MASA-Dearborn/STACK_PMS/README.md

# PMS
Power Management System board
STACK_PMS
