MASA-Dearborn/STACK_PMS/Power Management System Schematic.pdf

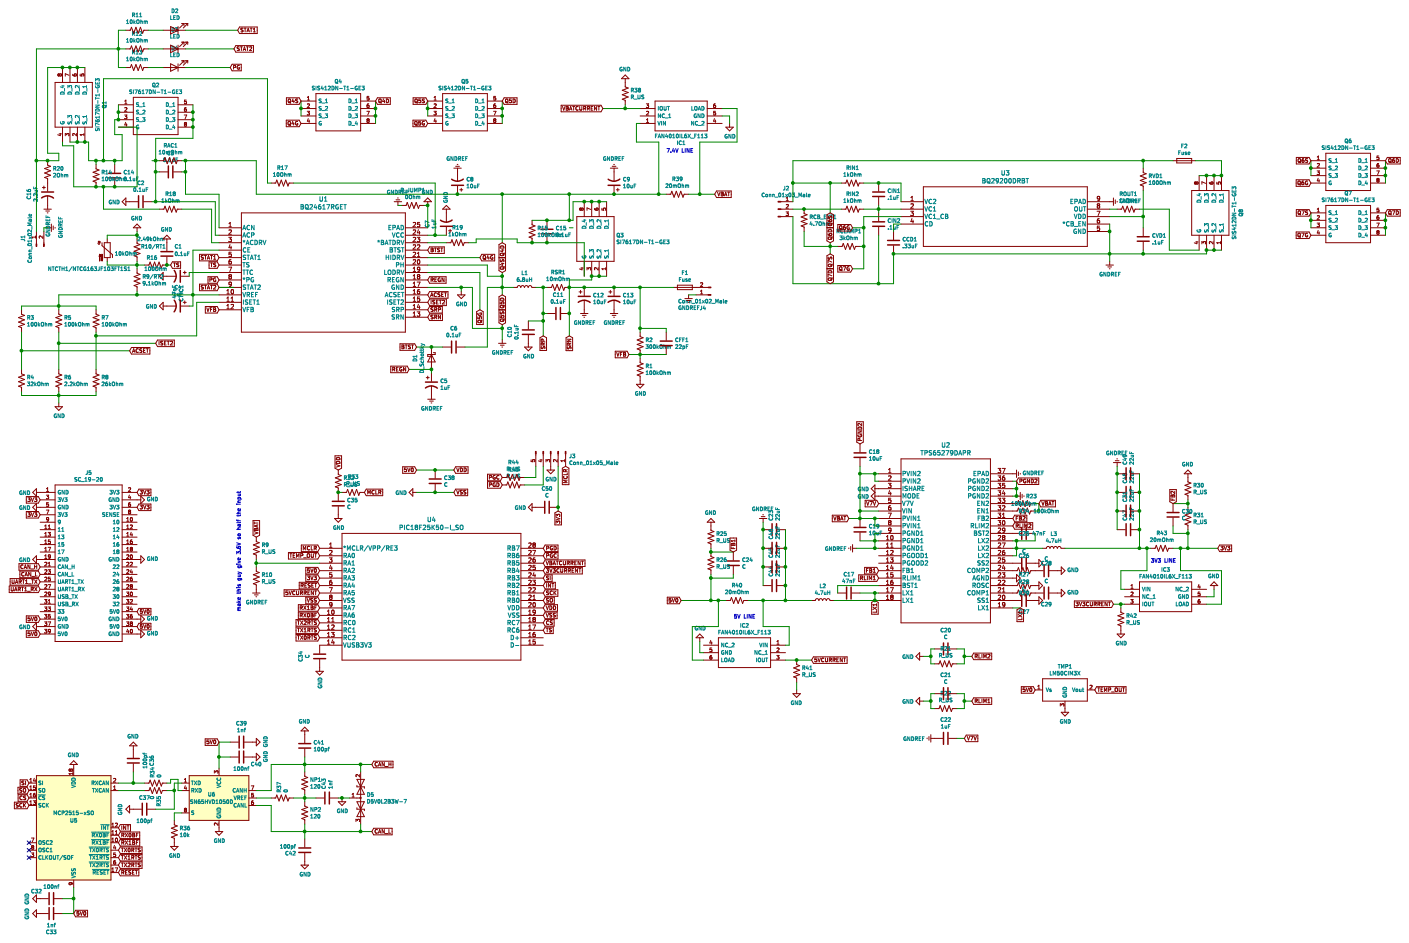
[picture p1: page 1]
