MASA-Dearborn/STACK_PMS/Power Management System GND Plane.pdf

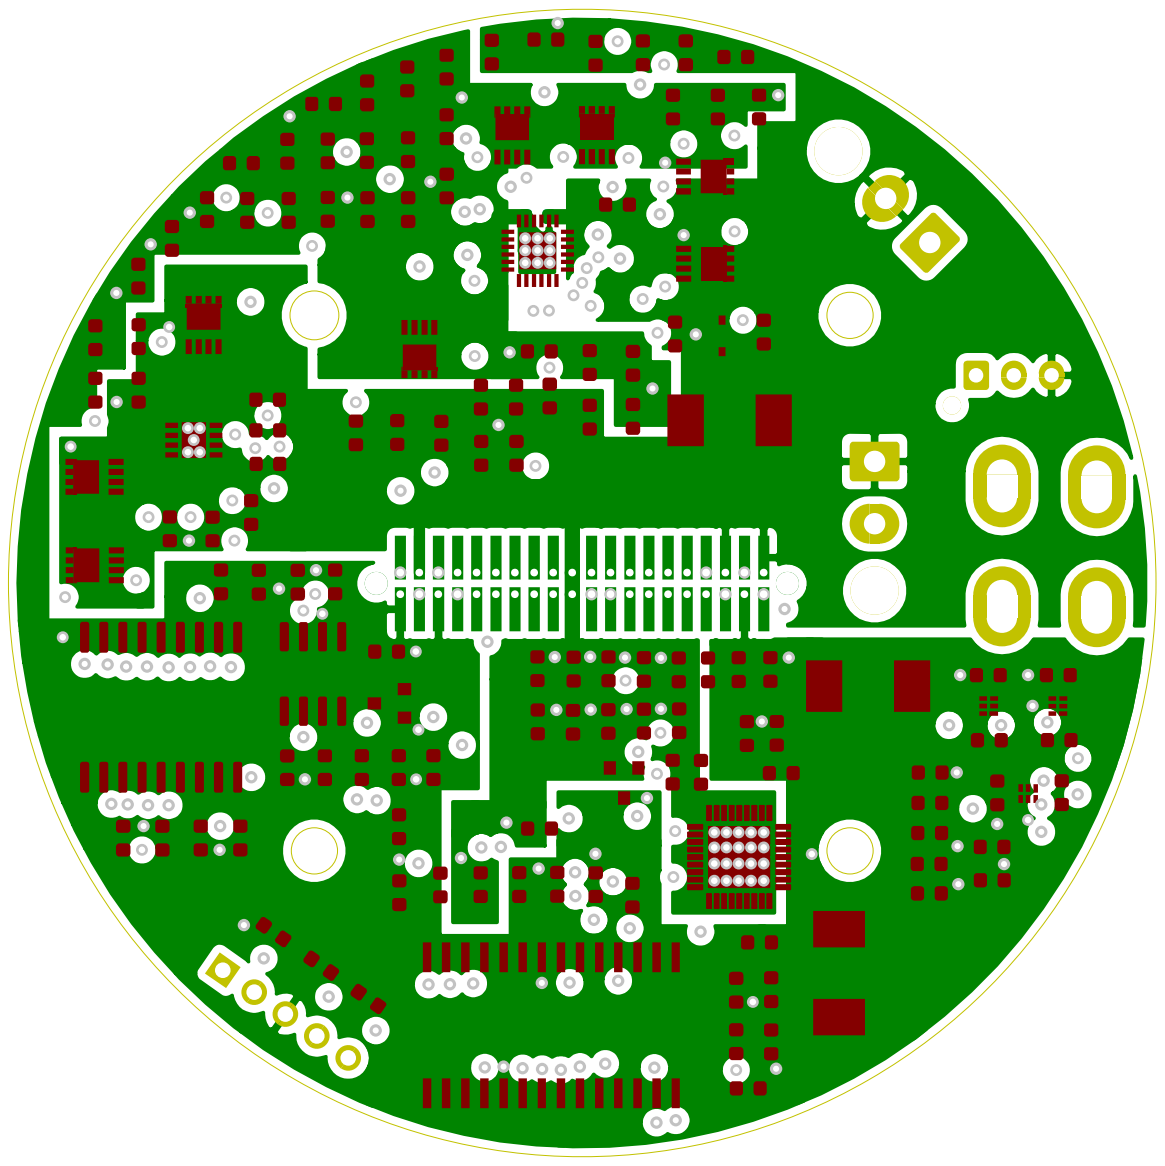
[picture p2: page 1]
