MASA-Dearborn/STACK_PMS/Power Management System Inner Layer.pdf

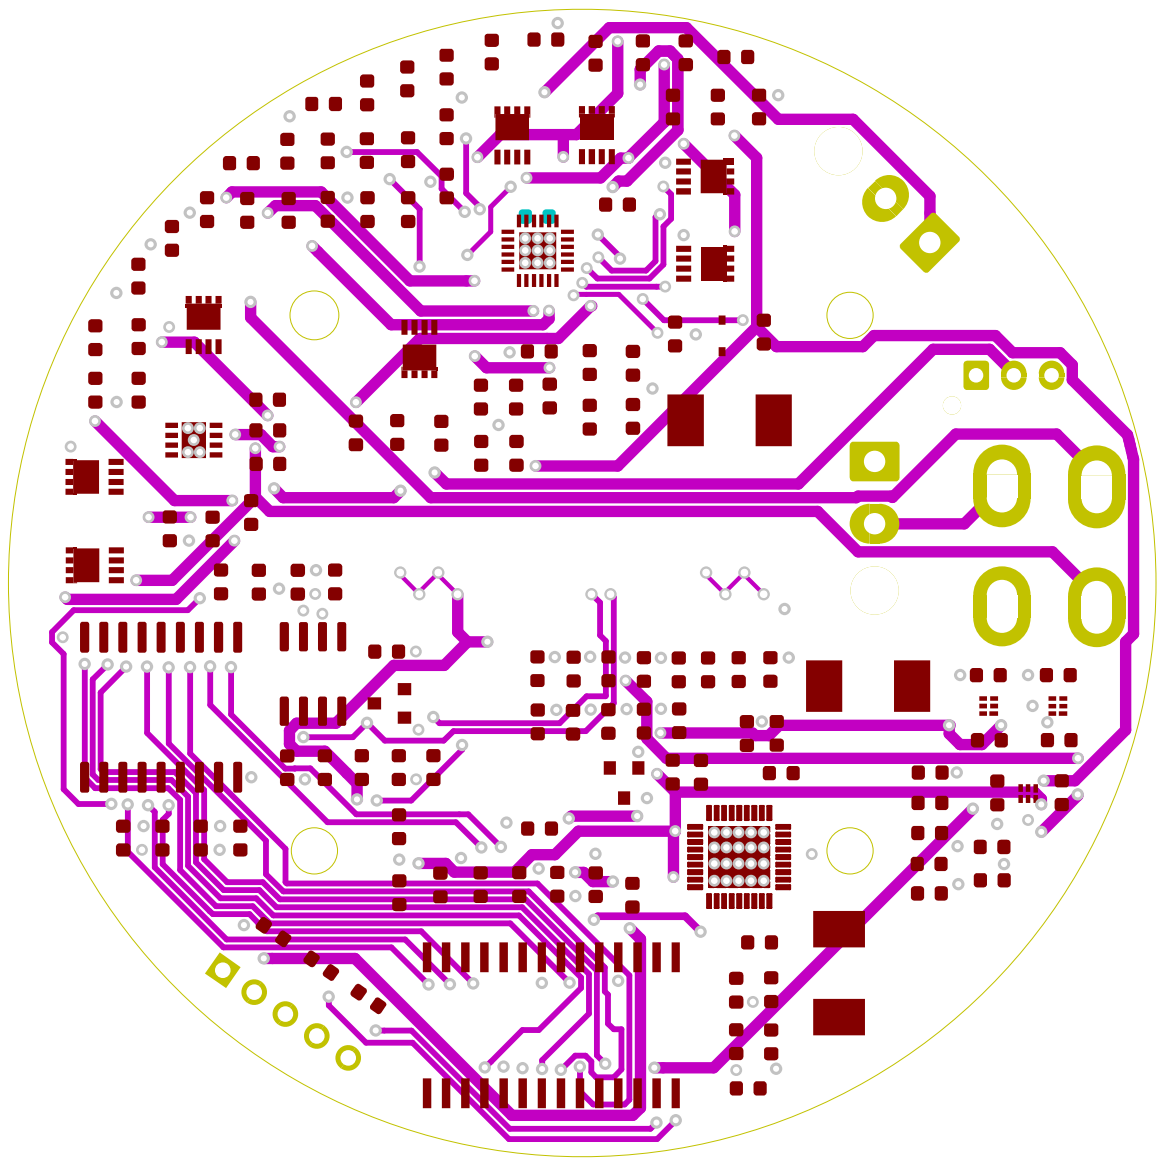
[picture p3: page 1]
