MASA-Dearborn/STACK_PMS/Power Management System Top Layer.pdf

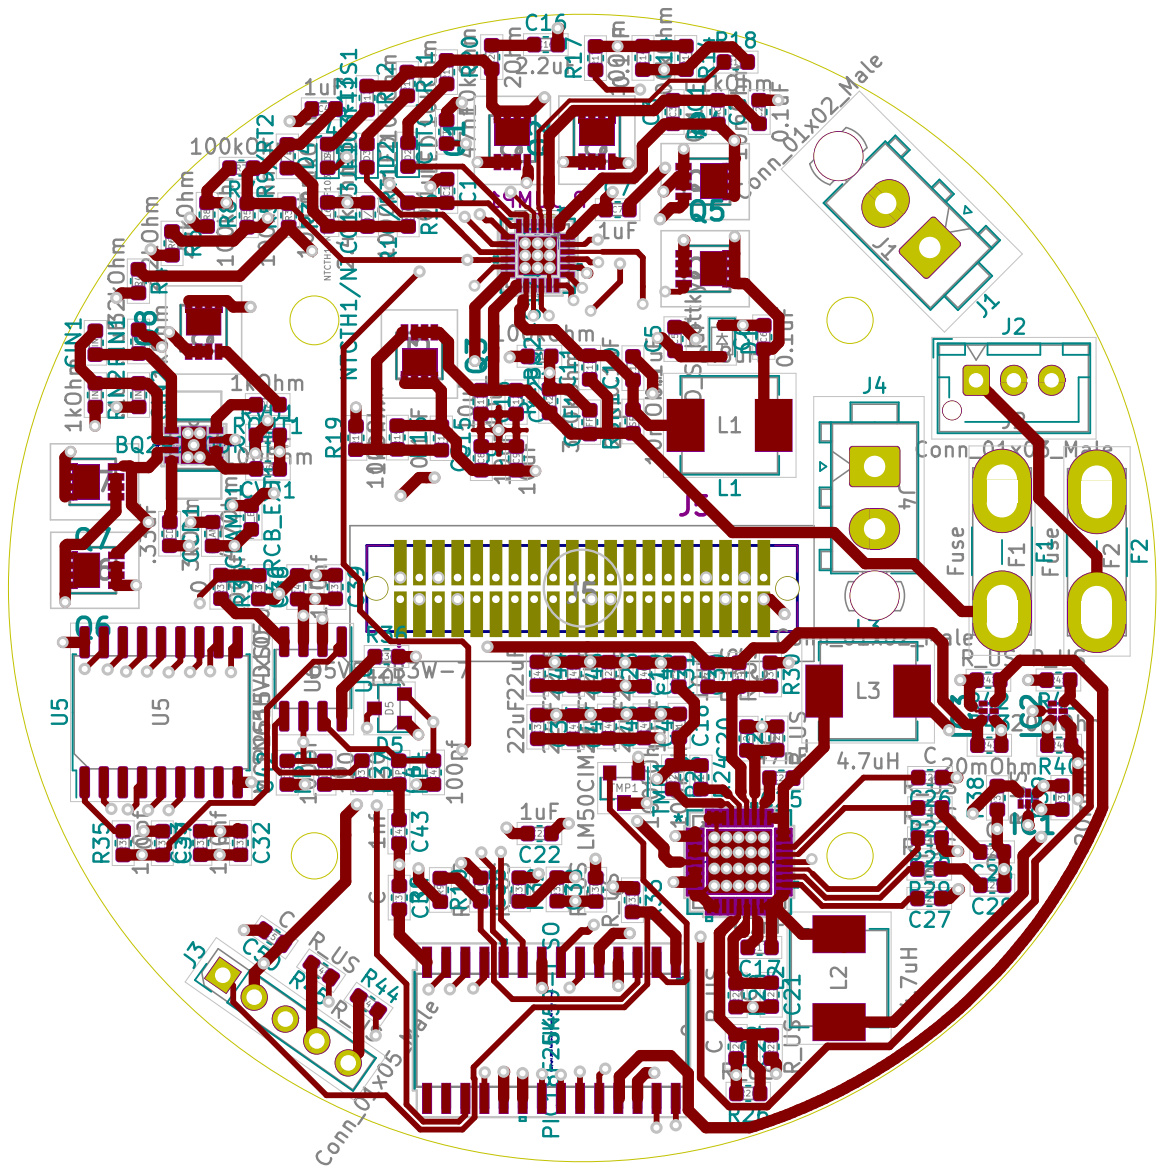
[picture p4: page 1]
