MASA-Dearborn/STACK_PMS/Batteryboard.kicad_pcb

## KiCad design Batteryboard.kicad_pcb (2020-02-20)

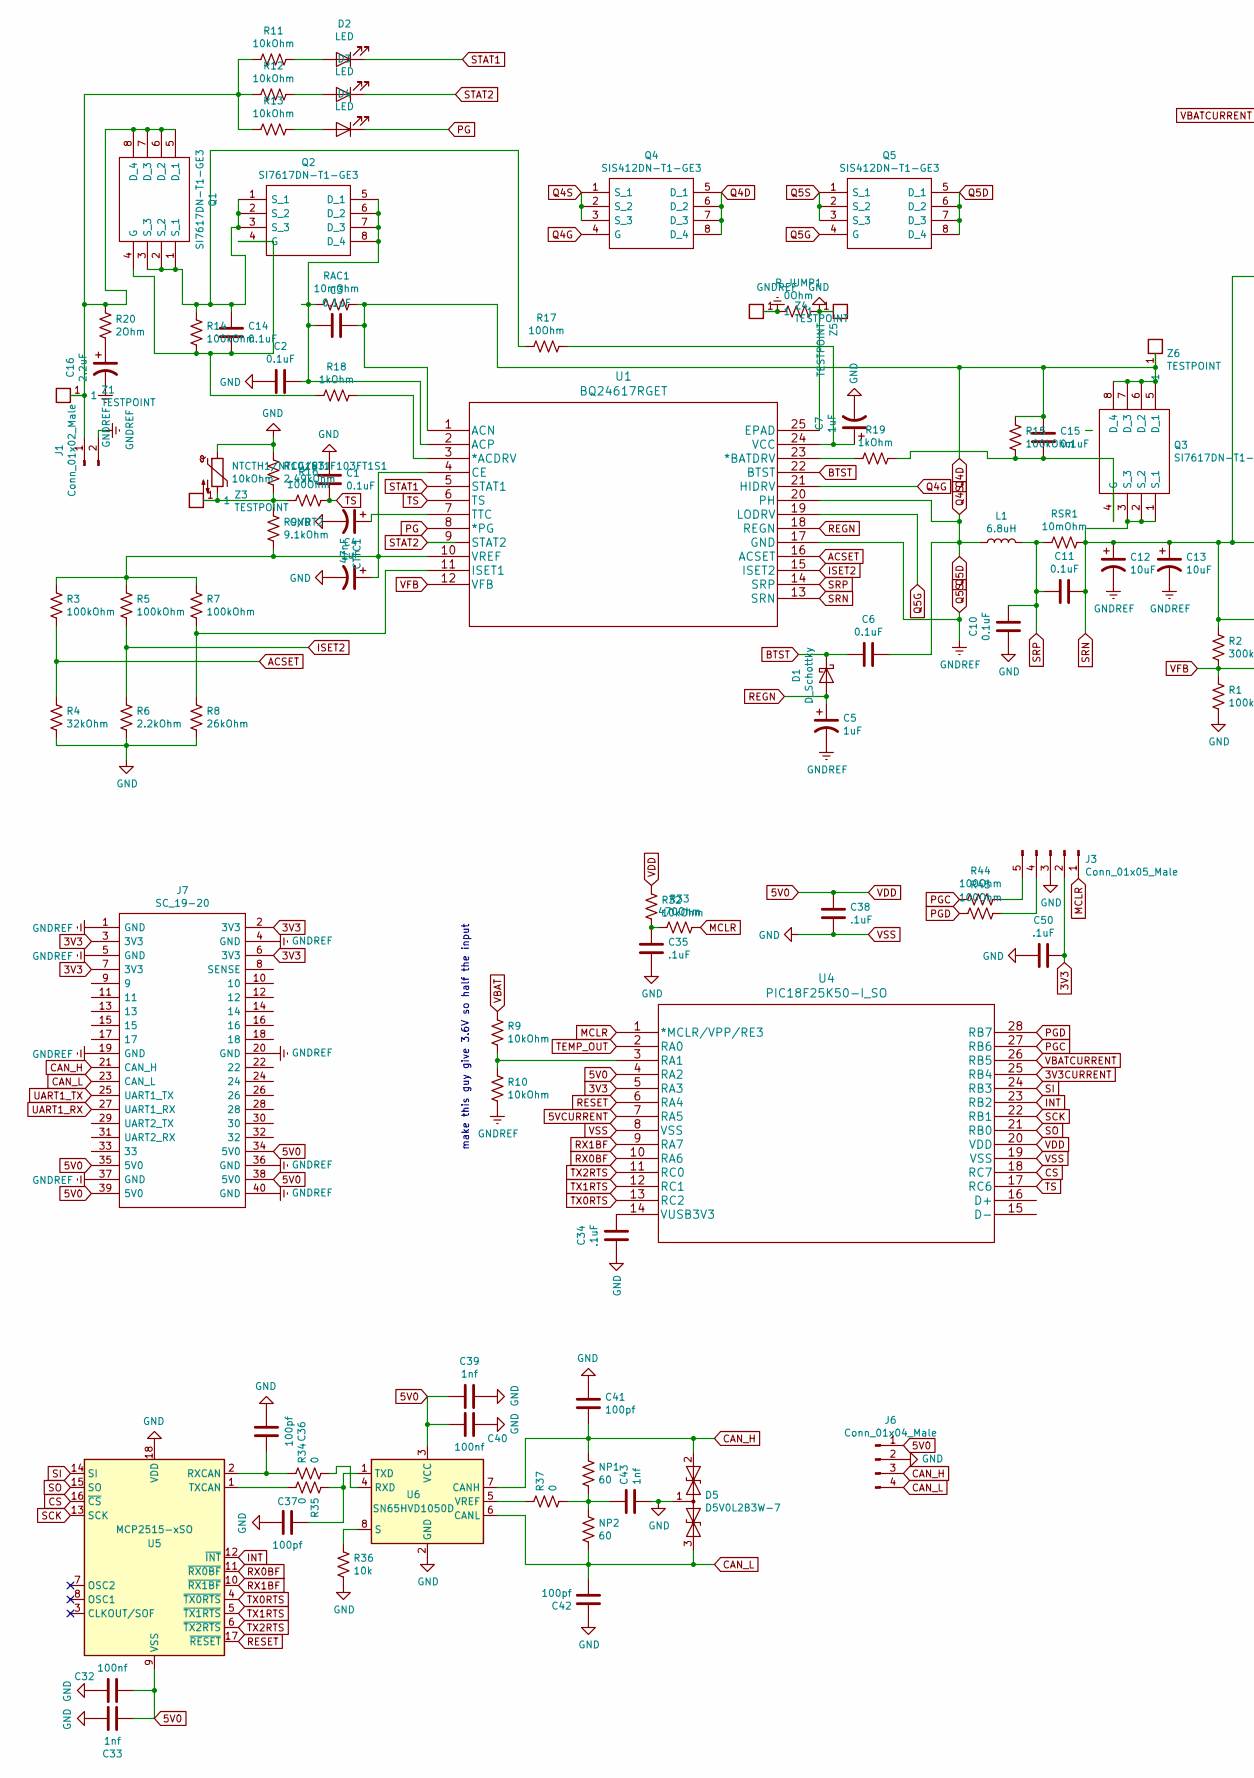
[picture p5: schematic Batteryboard.sch, part in row 1, column 1]

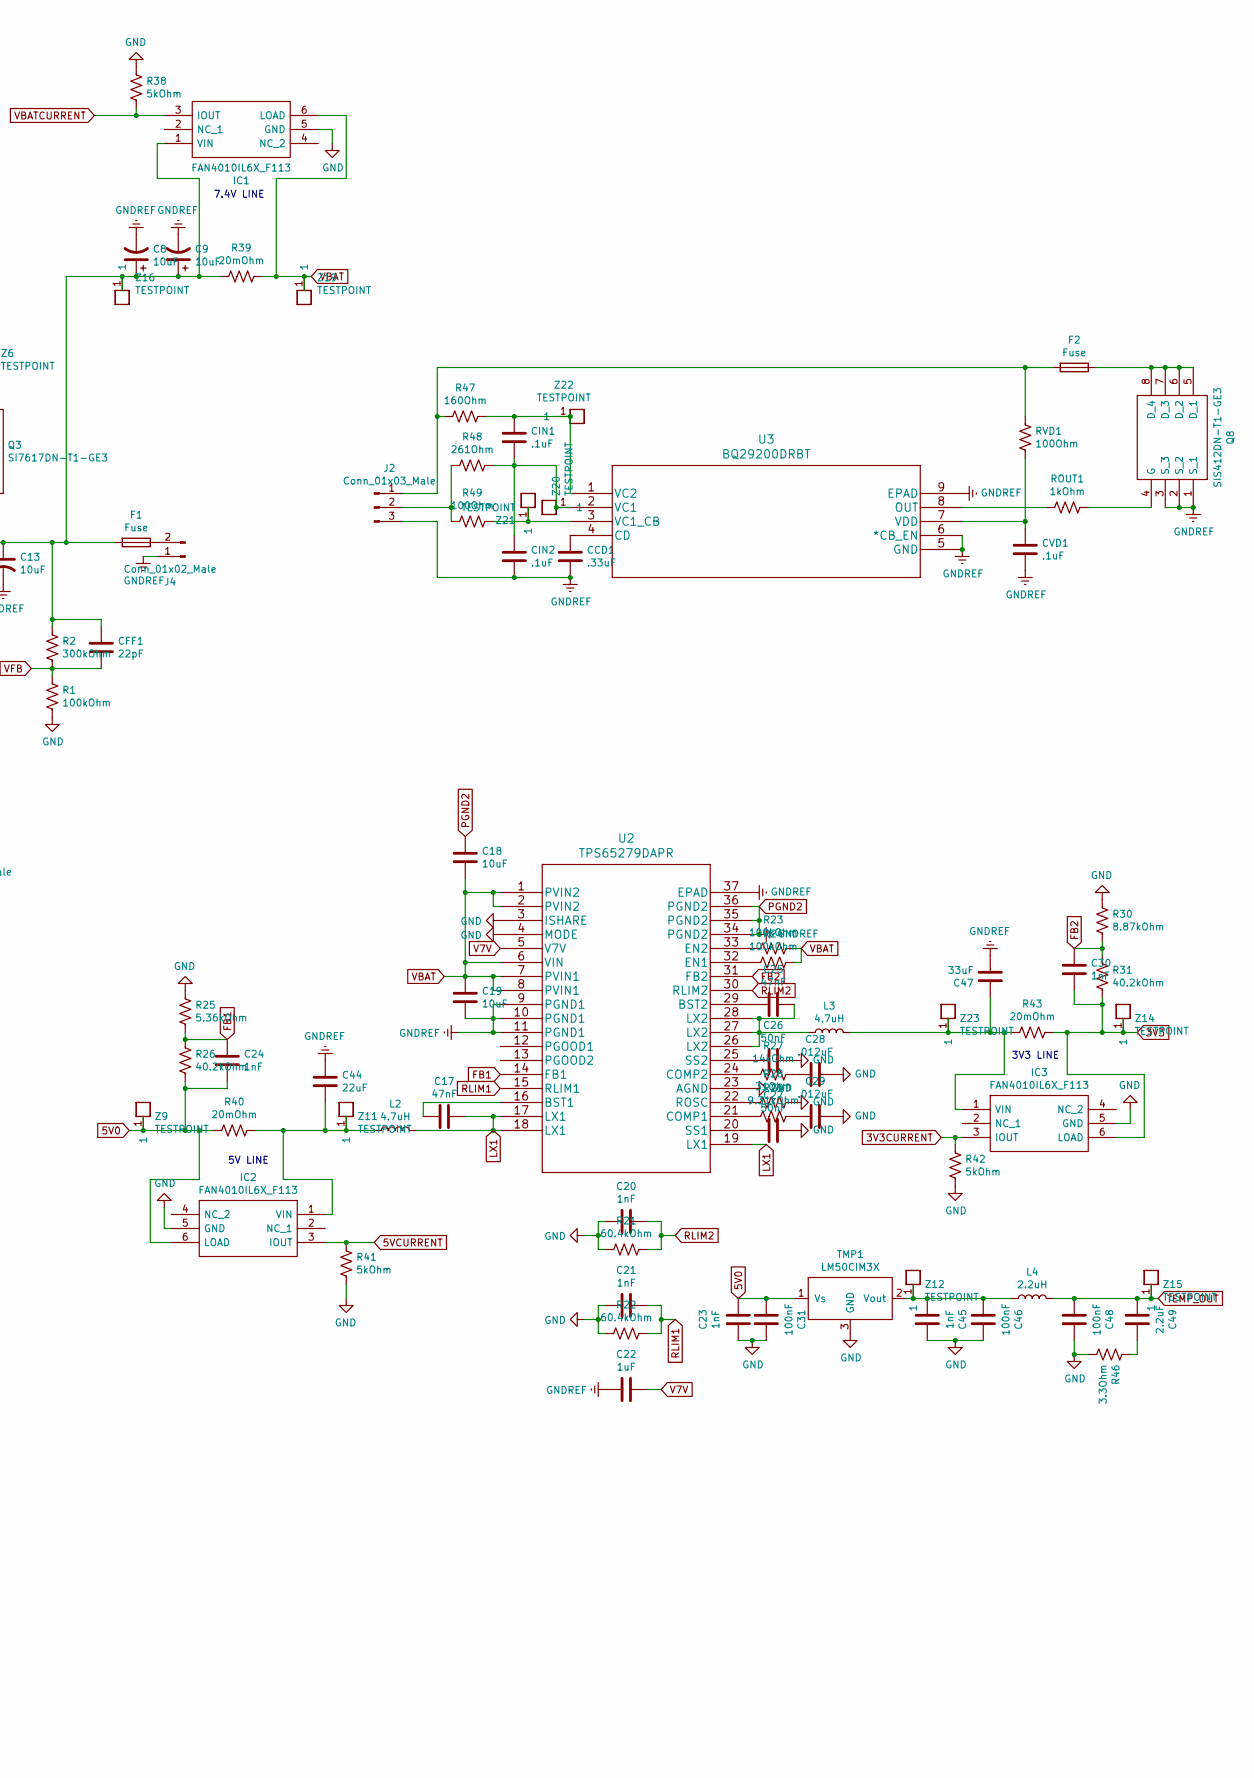
[picture p6: schematic Batteryboard.sch, part in row 1, column 2]

Parts:
C1, C2, C3, C6, C10, C11, C14, C15: 0.1uF; C_0603_1608Metric
C4, C5, C7, C22: 1uF; C_0603_1608Metric
C8, C9, C12, C13, C18, C19: 10uF; C_0603_1608Metric
C16, C49: 2.2uF; C_0603_1608Metric
C17, C25: 47nF; C_0603_1608Metric
C20, C21, C23, C24, C30, C45: 1nF; C_0603_1608Metric
C26, C27: 50nF; C_0603_1608Metric
C28, C29: .012uF; C_0603_1608Metric
C31, C46, C48: 100nF; C_0603_1608Metric
C32, C40: 100nf; C_0603_1608Metric
C33, C39, C43: 1nf; C_0603_1608Metric
C34, C35, C38, C50: .1uF; C_0603_1608Metric
C36, C37, C41, C42: 100pf; C_0603_1608Metric
C44: 22uF; C_0603_1608Metric
C47: 33uF; C_0805_2012Metric
CCD1: .33uF; C_0603_1608Metric
CFF1: 22pF; C_0603_1608Metric
CIN1, CIN2: .1uF; C_0603_1608Metric
CTTC1: 47nF; C_0603_1608Metric
CVD1: .1uF; C_0603_1608Metric
D1: D_Schottky; D_SOD-323
D2, D3, D4: LED; D_0603_1608Metric
D5: D5V0L2B3W-7; SOT-23
F1, F2: Fuse; Fuseholder_Blade_Mini_Keystone_3557-2
IC1, IC2, IC3: FAN4010IL6X_F113; 6-LEAD_MICROPAK; Manufacturer_Part_Number FAN4010IL6X_F113; Mouser Part Number 512-FAN4010IL6X_F113
J1, J4: Conn_01x02_Male; 1-1123723-2
J2: Conn_01x03_Male; JST_XH_B3B-XH-AM_1x03_P2.50mm_Vertical
J3: Conn_01x05_Male; PinHeader_1x05_P2.54mm_Vertical
J6: Conn_01x04_Male; 1734595-4
J7: SC_19-20; Stack_Connector_2019_2020; Manufacturer_Part_Number TFC-120-32-F-D-A-K-TR
L1: 6.8uH; L_Vishay_IHLP-2525
L2, L3: 4.7uH; SRP7030-4R7M
L4: 2.2uH; L_0603_1608Metric
NP1, NP2: 60; R_0603_1608Metric
NTCTH1/NTCG163JF103FT1S1: 10kOhm; R_0603_1608Metric
Q1, Q2, Q3: SI7617DN-T1-GE3; SIS862DNT1GE3; Mouser Part Number 781-SI7617DN-GE3
Q4, Q5, Q8: SIS412DN-T1-GE3; SIS862DNT1GE3; Mouser Part Number 781-SI7617DN-GE3
R1, R3, R5, R7, R14, R15, R23, R24: 100kOhm; R_0603_1608Metric
R2: 300kOhm; R_0603_1608Metric
R4: 32kOhm; R_0603_1608Metric
R6: 2.2kOhm; R_0603_1608Metric
R8: 26kOhm; R_0603_1608Metric
R9, R10, R11, R12, R13, R32: 10kOhm; R_0603_1608Metric
R9/RT2: 9.1kOhm; R_0603_1608Metric
R10/RT1: 2.49kOhm; R_0603_1608Metric
R16, R44, R45, R49: 100Ohm; R_0603_1608Metric
R17: 10Ohm; R_0603_1608Metric
R18, R19: 1kOhm; R_0603_1608Metric
R20: 2Ohm; R_0603_1608Metric
R21, R22: 60.4kOhm; R_0603_1608Metric
R25: 5.36kOhm; R_0603_1608Metric
R26, R31: 40.2kOhm; R_0603_1608Metric
R27: 14kOhm; R_0603_1608Metric
R28: 31Ohm; R_0603_1608Metric
R29: 9.31kOhm; R_0603_1608Metric
R30: 8.87kOhm; R_0603_1608Metric
R33: 470Ohm; R_0603_1608Metric
R34, R35, R37: 0; R_0603_1608Metric
R36: 10k; R_0603_1608Metric
R38, R41, R42: 5kOhm; R_0603_1608Metric
R39, R40, R43: 20mOhm; R_0603_1608Metric
R46: 3.3Ohm; R_0603_1608Metric
R47: 160Ohm; R_0603_1608Metric
R48: 261Ohm; R_0603_1608Metric
RAC1: 10mOhm; R_0603_1608Metric
ROUT1: 1kOhm; R_0603_1608Metric
RSR1: 10mOhm; R_0603_1608Metric
RVD1: 100Ohm; R_0603_1608Metric
R_JUMP1: 0Ohm; R_0603_1608Metric
TMP1: LM50CIM3X; SOT-23
U1: BQ24617RGET
U2: TPS65279DAPR
U3: BQ29200DRBT
U4: PIC18F25K50-I_SO; PIC18F25K50-I&slash_SO
U5: MCP2515-xSO; SOIC-18W_7.5x11.6mm_P1.27mm
U6: SN65HVD1050D; SOIC-8_3.9x4.9mm_P1.27mm
Z1, Z3, Z4, Z5, Z6, Z9, Z11, Z12, Z14, Z15, Z16, Z19, Z20, Z21, Z22, Z23: TESTPOINT

Connections:
3V3: C30.2, C50.1, IC3.6 (LOAD), J3.2, J7.2 (3V3), J7.3 (3V3), J7.6 (3V3), J7.7 (3V3), R31.2, R43.1, U4.5 (RA3), Z14.1
3V3CURRENT: IC3.3 (IOUT), R42.1, U4.25 (RB4)
5V0: C23.1, C24.2, C31.2, C32.1, C33.2, C38.1, C39.2, C40.1, IC2.6 (LOAD), J6.1, J7.34 (5V0), J7.35 (5V0), J7.38 (5V0), J7.39 (5V0), R26.2, R32.1, R40.2, TMP1.1 (Vs), U4.4 (RA2), U4.20 (VDD), U5.9 (VSS), U6.3 (VCC), Z9.1
5VCURRENT: IC2.3 (IOUT), R41.1, U4.7 (RA5)
ACSET: R3.2, R4.1, U1.16 (ACSET)
BTST: C6.2, D1.1 (K), U1.22 (BTST)
CAN_H: C41.2, D5.2 (A1), J6.3, J7.21 (CAN_H), NP1.1, U6.7 (CANH)
CAN_L: C42.2, D5.3 (A2), J6.4, J7.23 (CAN_L), NP2.2, U6.6 (CANL)
CS: U4.18 (RC7), U5.16 (~CS)
FB1: C24.1, R25.2, R26.1, U2.14 (FB1)
FB2: C30.1, R30.2, R31.1, U2.31 (FB2)
INT: U4.23 (RB2), U5.12 (~INT)
ISET2: R5.2, R6.1, U1.15 (ISET2)
LX1: C17.1, L2.2, U2.17 (LX1), U2.18 (LX1), U2.19 (LX1)
MCLR: J3.1, R33.2, U4.1 (*MCLR/VPP/RE3)
unnamed: C2.1, C3.2, Q2.5 (D_1), Q2.6 (D_2), Q2.7 (D_3), Q2.8 (D_4), RAC1.2, U1.2 (ACP)
unnamed: C4.1, R3.1, R5.1, R7.1, R9/RT2.2, U1.4 (CE), U1.10 (VREF)
unnamed: C7.1, R17.1, U1.24 (VCC)
unnamed: C14.1, Q1.1 (S_1), Q1.2 (S_2), Q1.3 (S_3), Q2.1 (S_1), Q2.2 (S_2), Q2.3 (S_3), R14.1, R17.2
unnamed: C14.2, Q1.4 (G), Q2.4 (G), R14.2, R18.2
unnamed: C15.2, Q3.4 (G), R15.2, R19.1
unnamed: C16.1, R20.2
unnamed: C17.2, U2.16 (BST1)
unnamed: C25.1, L3.1, U2.26 (LX2), U2.27 (LX2), U2.28 (LX2)
unnamed: C25.2, U2.29 (BST2)
unnamed: C26.2, U2.25 (SS2)
unnamed: C27.2, U2.20 (SS1)
unnamed: C28.2, R27.1
unnamed: C29.2, R29.1
unnamed: C34.2, U4.14 (VUSB3V3)
unnamed: C35.1, R32.2, R33.1
unnamed: C36.1, R34.1, U5.2 (RXCAN)
unnamed: C37.2, R35.1, U6.1 (TXD)
unnamed: C43.1, NP1.2, NP2.1, R37.2
unnamed: C44.2, IC2.1 (VIN), L2.1, R40.1, Z11.1
unnamed: C45.2, C46.2, L4.1, TMP1.2 (Vout), Z12.1
unnamed: C47.1, IC3.1 (VIN), L3.2, R43.2, Z23.1
unnamed: C49.1, R46.1
unnamed: CCD1.1, U3.4 (CD)
unnamed: CIN1.1, R47.1, U3.1 (VC2), Z22.1
unnamed: CIN1.2, CIN2.1, R48.1, U3.2 (VC1), Z20.1
unnamed: CTTC1.1, U1.7 (TTC)
unnamed: CVD1.1, RVD1.2, U3.7 (VDD)
unnamed: D2.2 (A), R11.1
unnamed: D3.2 (A), R12.1
unnamed: D4.2 (A), R13.1
unnamed: F1.1, J4.2
unnamed: F2.1, Q8.5 (D_1), Q8.6 (D_2), Q8.7 (D_3), Q8.8 (D_4)
unnamed: F2.2, J2.1, R47.2, RVD1.1
unnamed: J1.1, Q1.5 (D_1), Q1.6 (D_2), Q1.7 (D_3), Q1.8 (D_4), R11.2, R12.2, R13.2, R20.1, Z1.1
unnamed: J2.2, R48.2, R49.2
unnamed: J3.4, R45.2
unnamed: J3.5, R44.1
unnamed: NTCTH1/NTCG163JF103FT1S1.2, R9/RT2.1, R10/RT1.2, R16.2, Z3.1
unnamed: Q8.4 (G), ROUT1.1
unnamed: R7.2, R8.1, U1.11 (ISET1)
unnamed: R9.2, R10.1, U4.3 (RA1)
unnamed: R18.1, U1.3 (*ACDRV)
unnamed: R19.2, U1.23 (*BATDRV)
unnamed: R23.2, U2.33 (EN2)
unnamed: R24.2, U2.32 (EN1)
unnamed: R27.2, U2.24 (COMP2)
unnamed: R28.2, U2.22 (ROSC)
unnamed: R29.2, U2.21 (COMP1)
unnamed: R34.2, U6.4 (RXD)
unnamed: R35.2, U5.1 (TXCAN)
unnamed: R36.1, U6.8 (S)
unnamed: R37.1, U6.5 (VREF)
unnamed: R49.1, U3.3 (VC1_CB), Z21.1
unnamed: ROUT1.2, U3.8 (OUT)
PG: D4.1 (K), U1.8 (*PG)
PGC: R44.2, U4.27 (RB6)
PGD: R45.1, U4.28 (RB7)
PGND2: C5.2, C8.2, C9.2, C12.2, C13.2, C16.2, C18.1, C19.2, C22.2, C44.1, C47.2, CCD1.2, CIN2.2, CVD1.2, J1.2, J2.3, J4.1, J7.1 (GND), J7.4 (GND), J7.5 (GND), J7.19 (GND), J7.20 (GND), J7.36 (GND), J7.37 (GND), J7.40 (GND), Q5.1 (S_1), Q5.2 (S_2), Q5.3 (S_3), Q8.1 (S_1), Q8.2 (S_2), Q8.3 (S_3), R10.2, R_JUMP1.2, U1.17 (GND), U2.9 (PGND1), U2.10 (PGND1), U2.11 (PGND1), U2.34 (PGND2), U2.35 (PGND2), U2.36 (PGND2), U2.37 (EPAD), U3.5 (GND), U3.6 (*CB_EN), U3.9 (EPAD), Z4.1
Q4D: C3.1, C15.1, Q3.5 (D_1), Q3.6 (D_2), Q3.7 (D_3), Q3.8 (D_4), Q4.5 (D_1), Q4.6 (D_2), Q4.7 (D_3), Q4.8 (D_4), R15.1, RAC1.1, U1.1 (ACN), Z6.1
Q4G: Q4.4 (G), U1.21 (HIDRV)
Q4S: C6.1, L1.1, Q4.1 (S_1), Q4.2 (S_2), Q4.3 (S_3), Q5.5 (D_1), Q5.6 (D_2), Q5.7 (D_3), Q5.8 (D_4), U1.20 (PH)
Q5G: Q5.4 (G), U1.19 (LODRV)
REGN: C5.1, D1.2 (A), U1.18 (REGN)
RESET: U4.6 (RA4), U5.17 (~RESET)
RLIM1: C21.1, R22.1, U2.15 (RLIM1)
RLIM2: C20.1, R21.1, U2.30 (RLIM2)
RX0BF: U4.10 (RA6), U5.11 (~RX0BF)
RX1BF: U4.9 (RA7), U5.10 (~RX1BF)
SCK: U4.22 (RB1), U5.13 (SCK)
SI: U4.24 (RB3), U5.14 (SI)
SO: U4.21 (RB0), U5.15 (SO)
SRN: C8.1, C9.1, C11.1, C12.1, C13.1, CFF1.1, F1.2, IC1.1 (VIN), Q3.1 (S_1), Q3.2 (S_2), Q3.3 (S_3), R2.1, R39.2, RSR1.1, U1.13 (SRN), Z16.1
SRP: C10.1, C11.2, L1.2, RSR1.2, U1.14 (SRP)
STAT1: D2.1 (K), U1.5 (STAT1)
STAT2: D3.1 (K), U1.9 (STAT2)
TEMP_OUT: C48.2, C49.2, L4.2, U4.2 (RA0), Z15.1
TS: C1.2, R16.1, U1.6 (TS), U4.17 (RC6)
TX0RTS: U4.13 (RC2), U5.4 (~TX0RTS)
TX1RTS: U4.12 (RC1), U5.5 (~TX1RTS)
TX2RTS: U4.11 (RC0), U5.6 (~TX2RTS)
V7V: C22.1, U2.5 (V7V)
VBAT: C18.2, C19.1, IC1.6 (LOAD), R9.1, R23.1, R24.1, R39.1, U2.1 (PVIN2), U2.2 (PVIN2), U2.6 (VIN), U2.7 (PVIN1), U2.8 (PVIN1), Z19.1
VBATCURRENT: IC1.3 (IOUT), R38.2, U4.26 (RB5)
VFB: CFF1.2, R1.1, R2.2, U1.12 (VFB)
VSS: C1.1, C2.2, C4.2, C7.2, C10.2, C20.2, C21.2, C23.2, C26.1, C27.1, C28.1, C29.1, C31.1, C32.2, C33.1, C34.1, C35.2, C36.2, C37.1, C38.2, C39.1, C40.2, C41.1, C42.1, C43.2, C45.1, C46.1, C48.1, C50.2, CTTC1.2, D5.1 (common), IC1.5 (GND), IC2.5 (GND), IC3.5 (GND), J3.3, J6.2, NTCTH1/NTCG163JF103FT1S1.1, R1.2, R4.2, R6.2, R8.2, R10/RT1.1, R21.2, R22.2, R25.1, R28.1, R30.1, R36.2, R38.1, R41.2, R42.2, R46.2, R_JUMP1.1, TMP1.3 (GND), U1.25 (EPAD), U2.3 (ISHARE), U2.4 (MODE), U2.23 (AGND), U4.8 (VSS), U4.19 (VSS), U5.18 (VDD), U6.2 (GND), Z5.1

Notes on the sheet:
3V3 LINE
5V LINE
make this guy give 3.6V so half the input
7.4V LINE

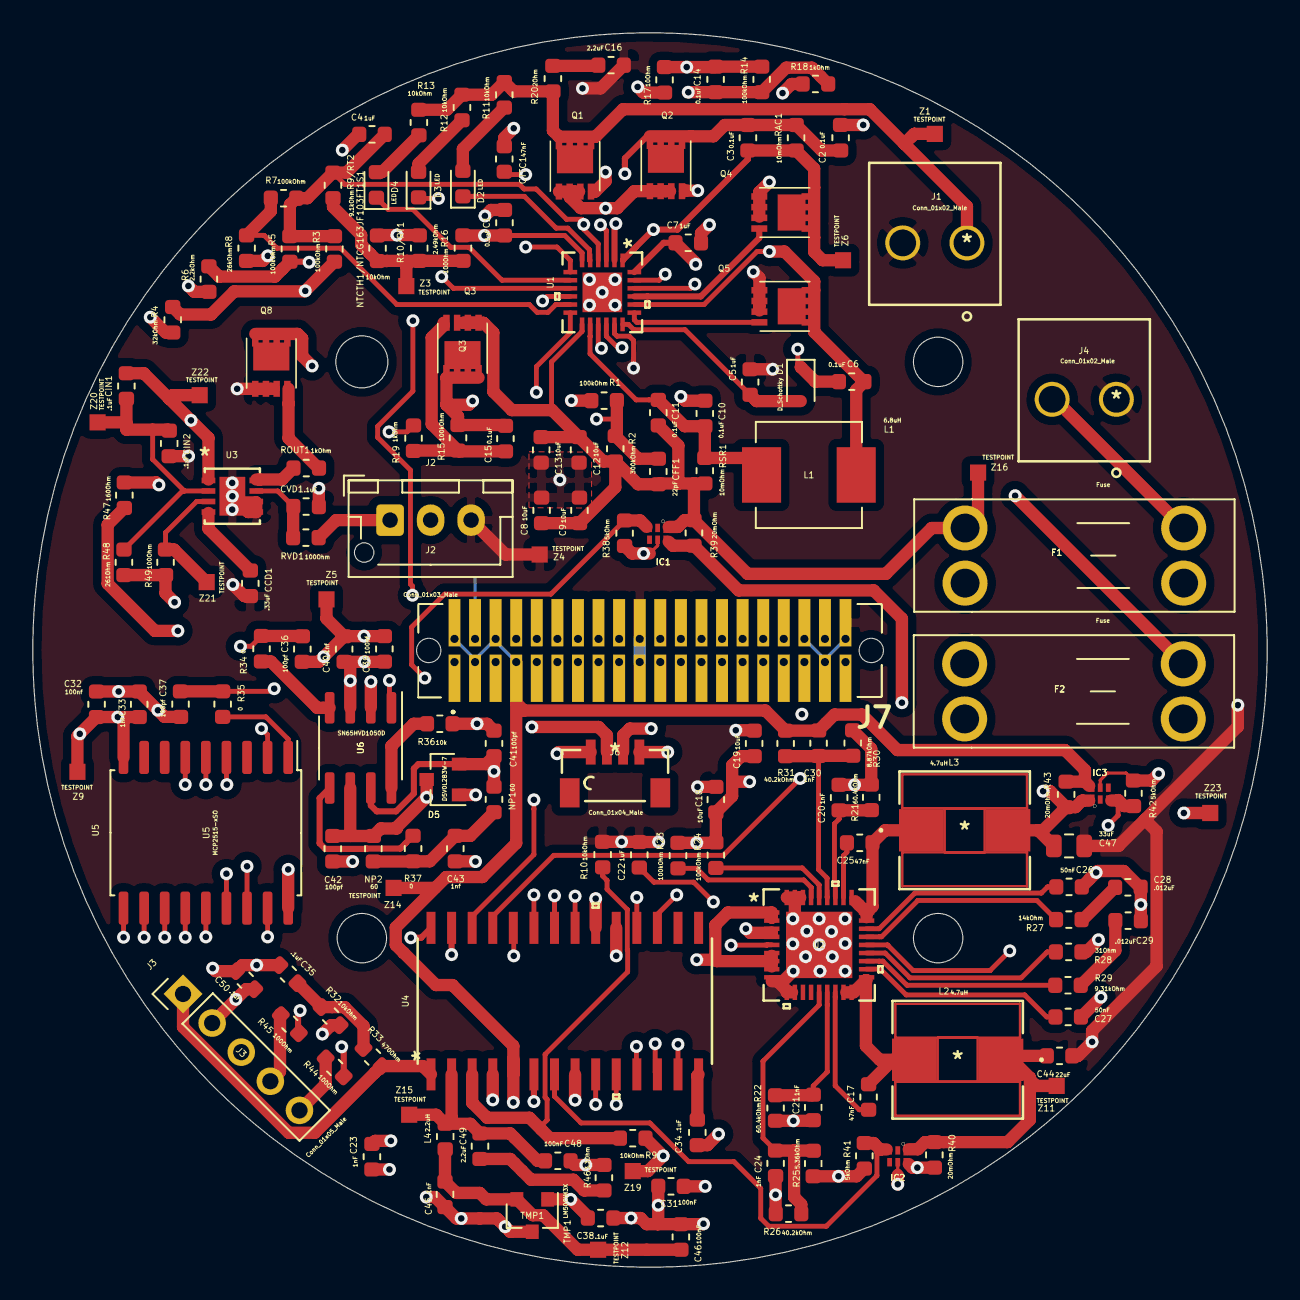
[picture p7: board Batteryboard.kicad_pcb from above]

Board: 4 copper layers, 76.2 x 76.2 mm, 164 parts (1 on the bottom side), 101 nets.
