MASA-Dearborn/STACK_PMS/(commit log)

2019-11-20 Silkscreen Fixed
    [Batteryboard.kicad_pcb, Batteryboard.sch]
2019-11-21 Didn't save schematic
    [Batteryboard.sch]
2019-12-22 Final PMS test board, ready for Stefka, and then printing
    [Batteryboard.kicad_pcb, Batteryboard.sch]
2019-12-24 first commit, board still has a ways to go
2019-12-24 first commit, still have a way to go
    [Batteryboard.kicad_pcb, batteryboardTry2.kicad_pcb]
2019-12-25 made lots of progress schematic wise, still need to add a few things to be sure, but its progress
    [Batteryboard.kicad_pcb, Batteryboard.sch, CAN_template.sch]
2019-12-27 more progress on the way to being done, added a bunch of stuff having to do with current sense
    [Batteryboard.kicad_pcb, Batteryboard.sch]
2019-12-29 finished schematic, more or less
    [Batteryboard.kicad_pcb, Batteryboard.sch]
2019-12-30 made progress on layout, charging IC is basically done
    [Batteryboard.kicad_pcb, Batteryboard.sch]
2019-12-30 added in layout for battery balancing IC
    [Batteryboard.kicad_pcb]
2019-12-31 added layout for buck converter
    [Batteryboard.kicad_pcb, Batteryboard.sch]
2020-01-01 got all components on there, routing and grounding to do still
    [Batteryboard.kicad_pcb]
2020-01-02 routing done, need to figure out grounding everything still
    [Batteryboard.kicad_pcb]
2020-01-12 complete overhaul of board, trying to make it a bit better
    [Batteryboard.kicad_pcb, Batteryboard.sch]
2020-01-12 finished for the night, 80 something traces left, then onto implementing proper grounding, which should be easy given that I have a huge uninterrupted ground plane to work with
    [Batteryboard.kicad_pcb]
2020-01-13 finished rotuing all my traces, grounding next
    [Batteryboard.kicad_pcb]
2020-01-13 grounded everything, hopefully well, but that is not a guarantee
    [Batteryboard.kicad_pcb]
2020-01-14 fixed current sense ICs
    [Batteryboard.kicad_pcb, Batteryboard.sch]
2020-01-22 fixed some stuff, grounding and a few traces
    [Batteryboard.kicad_pcb, Batteryboard.sch]
2020-01-22 fixed another little trace
    [Batteryboard.kicad_pcb]
2020-01-30 big overhaul on board, did a bunch of stuff
    [Batteryboard.kicad_pcb, Batteryboard.sch]
2020-02-02 basically an emergency backup, going to reroute my board
    [Batteryboard.kicad_pcb, Batteryboard.sch]
2020-02-02 here u go matt, thanks for helping make this bomb
    [Batteryboard.kicad_pcb]
2020-02-02 Fixed CAN resistors and added filtering
    [Batteryboard.sch]
2020-02-03 schematic is final now, working on routing my board again
    [Batteryboard.kicad_pcb, Batteryboard.sch]
2020-02-04 did my board again, heck yeah, actually quite happy with it this time
    [Batteryboard.kicad_pcb]
2020-02-07 added 4 pin for AOA sensor
    [Batteryboard.kicad_pcb, Batteryboard.sch]
2020-02-08 made lots of progress on silkscreen, and fixed some jank with values
    [Batteryboard.kicad_pcb, Batteryboard.sch]
2020-02-08 board is actually done?
    [Batteryboard.kicad_pcb]
2020-02-09 k its like super done this time
    [Batteryboard.kicad_pcb]
2020-02-09 fixed silkscreen up more
    [Batteryboard.kicad_pcb]
2020-02-09 there was 1 more resistor needed fixed
    [Batteryboard.kicad_pcb]
2020-02-09 Fixed silk screen
    [Batteryboard.csv, Batteryboard.kicad_pcb]
2020-02-11 addede pms silkscreen
    [Batteryboard.kicad_pcb]
2020-02-18 changed up balancing circuit cuz that no work and that bad
    [Batteryboard.kicad_pcb, Batteryboard.sch]
2020-02-18 made some finishing touches, should be complete now
    [Batteryboard.kicad_pcb, Batteryboard.sch]
2020-02-19 fixed stuff
    [Batteryboard.kicad_pcb, Batteryboard.sch]
2020-02-20 fixed some shit
    [Batteryboard.kicad_pcb, Batteryboard.sch]
2020-02-20 added ground pours
    [Batteryboard.kicad_pcb]
